sehajveersinghsaini/ecocar-onboarding-pcb/hardware/ecocar_onboarding/ecocar_onboarding.pdf

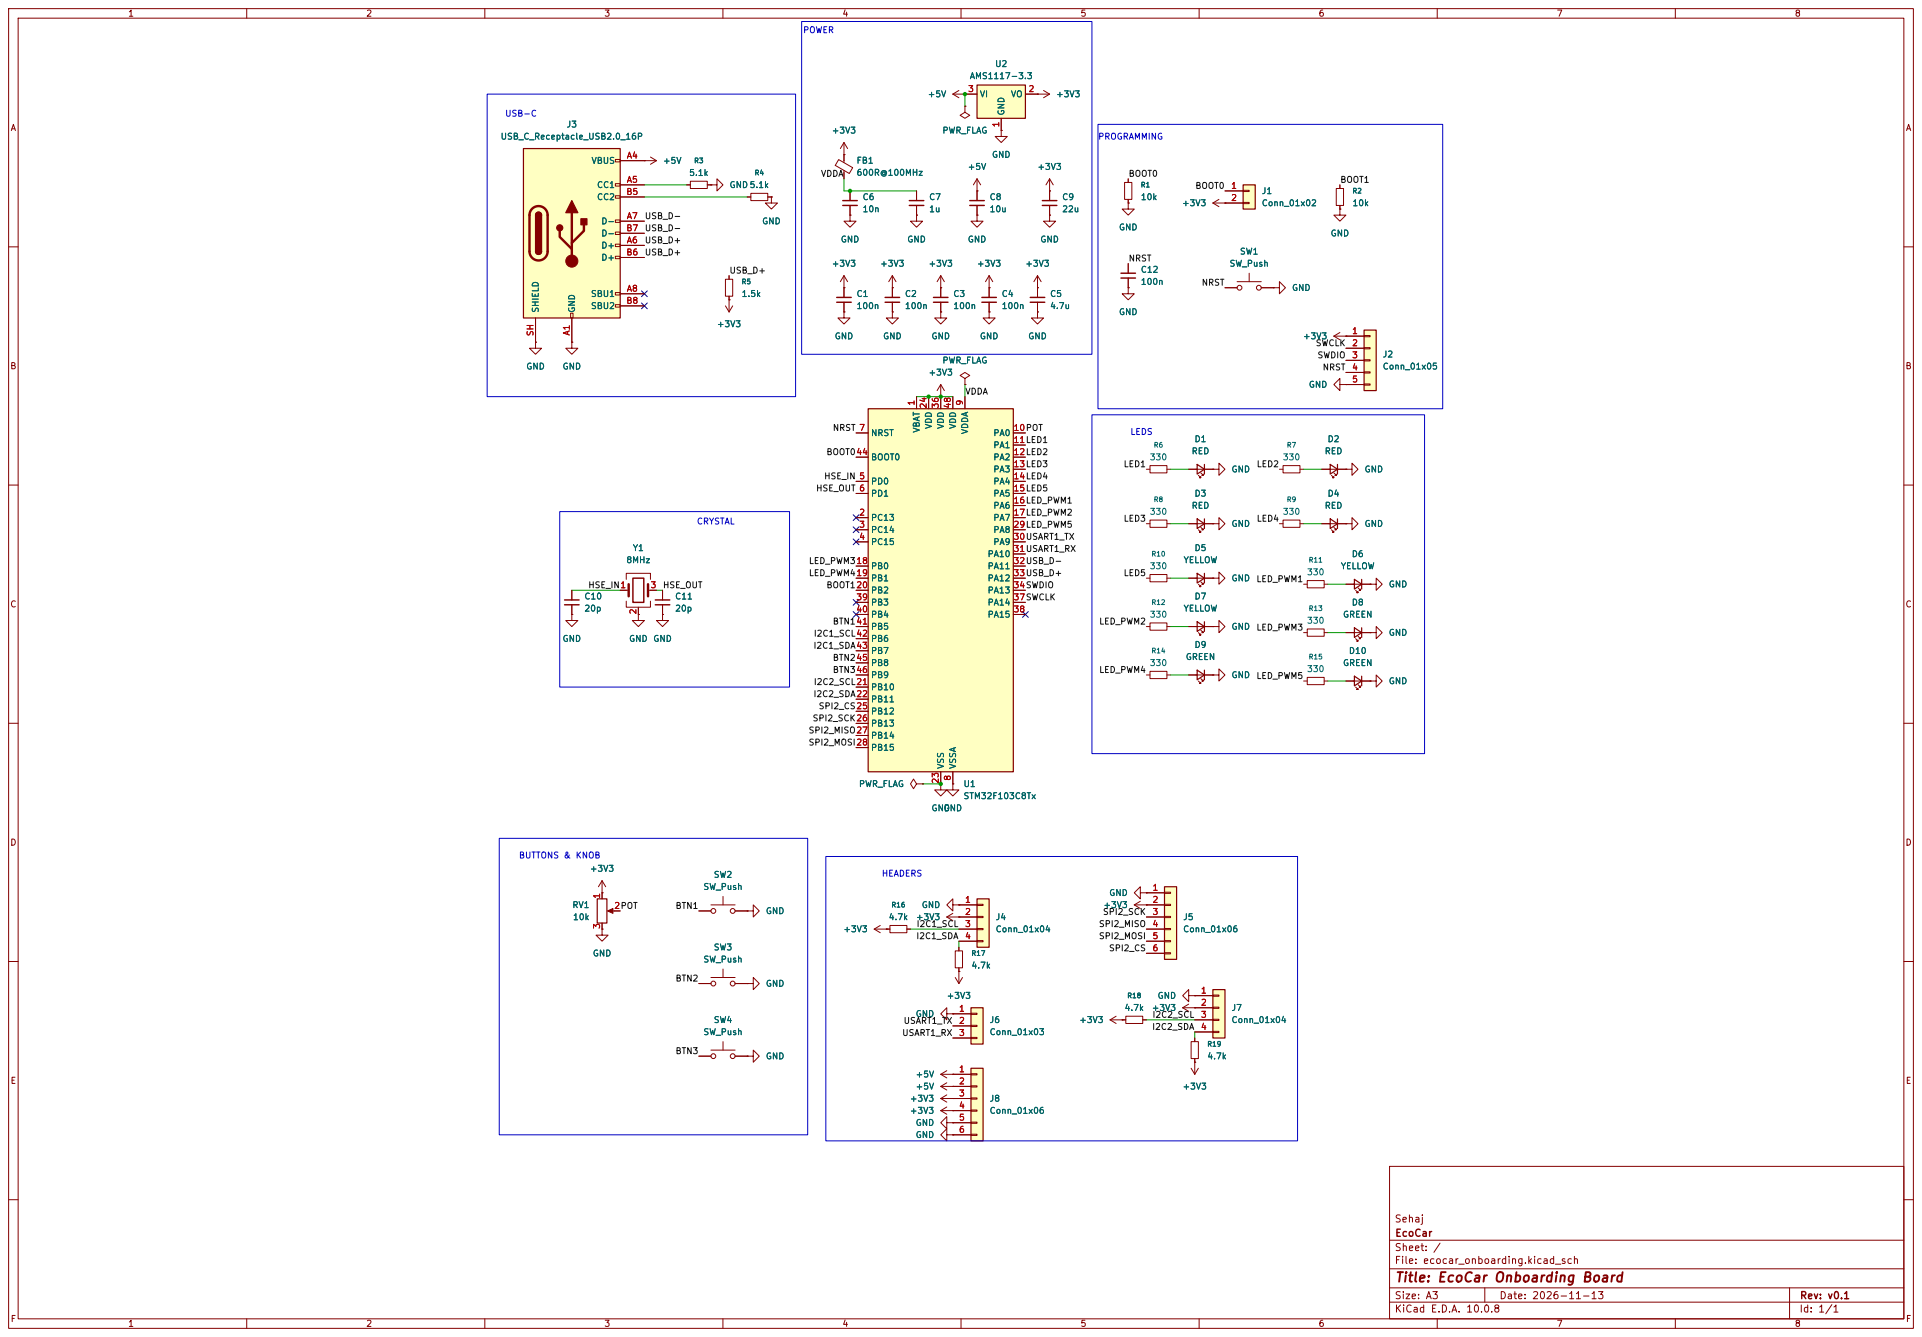
[picture p2: page 1]

Size: A3 | Rev: v0.1
KiCad E.D.A. 10.0.8 | Id: 1/1
