sehajveersinghsaini/ecocar-onboarding-pcb/hardware/ecocar_onboarding/ecocar_onboarding.kicad_pcb

## KiCad design hardware/ecocar_onboarding/ecocar_onboarding.kicad_pcb (2026-11-13)

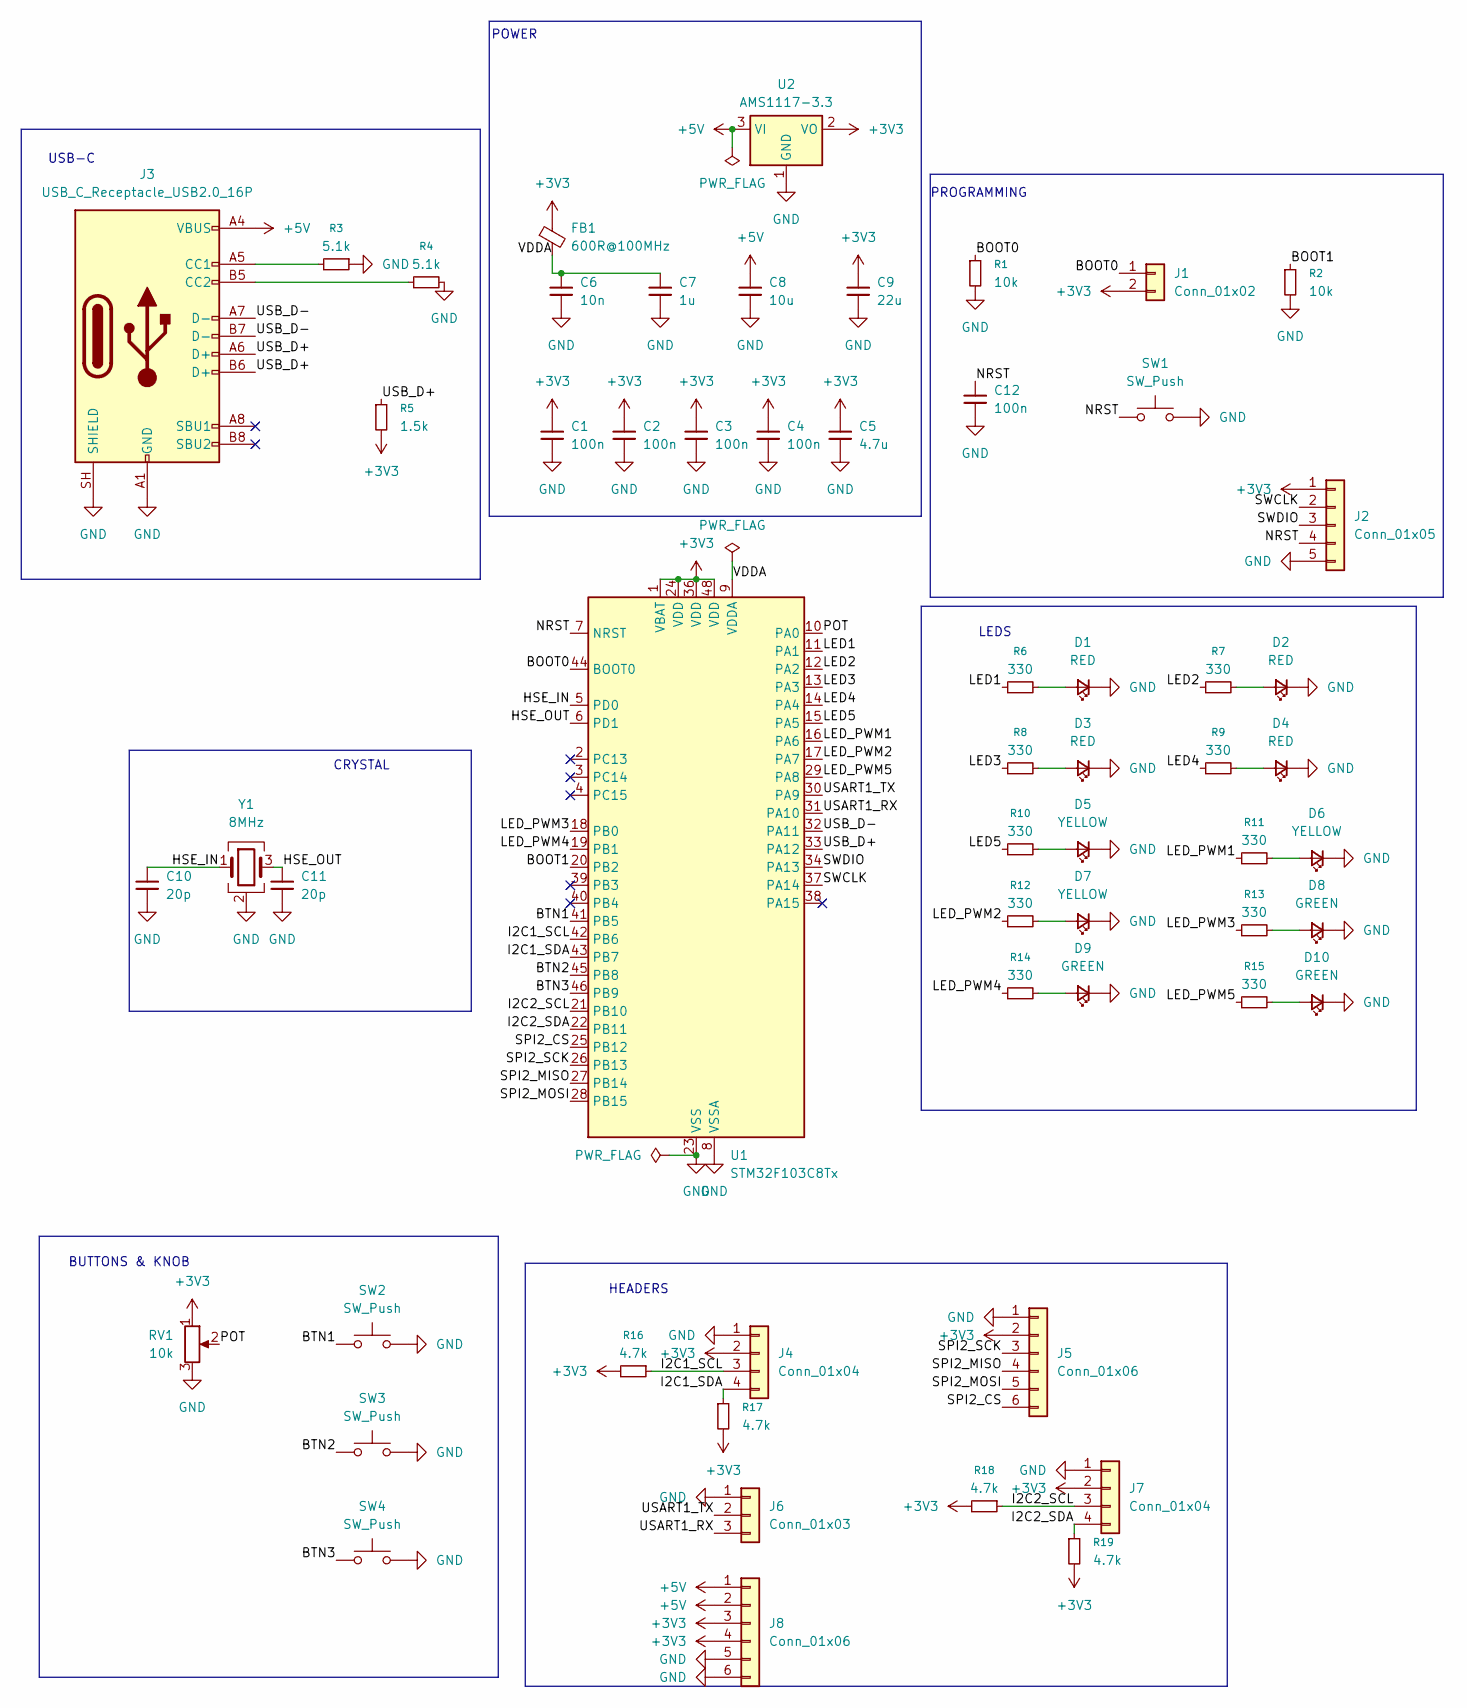
[picture p3: schematic ecocar_onboarding.kicad_sch, EcoCar Onboarding Board]

Parts:
C1, C2, C3, C4, C12: 100n; C_0603_1608Metric
C5: 4.7u; C_0805_2012Metric
C6: 10n; C_0603_1608Metric
C7: 1u; C_0603_1608Metric
C8: 10u; C_0805_2012Metric
C9: 22u; C_0805_2012Metric
C10, C11: 20p; C_0603_1608Metric
D1, D2, D3, D4: RED; LED_0603_1608Metric
D5, D6, D7: YELLOW; LED_0603_1608Metric
D8, D9, D10: GREEN; LED_0603_1608Metric
FB1: 600R@100MHz; L_0603_1608Metric
J1: Conn_01x02; PinHeader_1x02_P2.54mm_Vertical
J2: Conn_01x05; PinHeader_1x05_P2.54mm_Vertical
J3: USB_C_Receptacle_USB2.0_16P; USB_C_Receptacle_HRO_TYPE-C-31-M-12
J4, J7: Conn_01x04; PinHeader_1x04_P2.54mm_Vertical
J5, J8: Conn_01x06; PinHeader_1x06_P2.54mm_Vertical
J6: Conn_01x03; PinHeader_1x03_P2.54mm_Vertical
R1, R2: 10k; R_0603_1608Metric
R3, R4: 5.1k; R_0603_1608Metric
R5: 1.5k; R_0603_1608Metric
R6, R7, R8, R9, R10, R11, R12, R13, R14, R15: 330; R_0603_1608Metric
R16, R17, R18, R19: 4.7k; R_0603_1608Metric
RV1: 10k; Potentiometer_Bourns_3386P_Vertical
SW1, SW2, SW3, SW4: SW_Push; SW_PUSH_6mm
U1: STM32F103C8Tx; LQFP-48_7x7mm_P0.5mm
U2: AMS1117-3.3; SOT-223-3_TabPin2
Y1: 8MHz; Crystal_SMD_3225-4Pin_3.2x2.5mm

Connections:
+3V3: C1.1, C2.1, C3.1, C4.1, C5.1, C9.1, FB1.1, J1.2, J2.1, J4.2, J5.2, J7.2, J8.3, J8.4, R5.2, R16.2, R17.2, R18.2, R19.2, RV1.1, U1.1 (VBAT), U1.24 (VDD), U1.36 (VDD), U1.48 (VDD), U2.2 (VO)
+5V: C8.1, J3.A4 (VBUS), J3.A9 (VBUS), J3.B4 (VBUS), J3.B9 (VBUS), J8.1, J8.2, U2.3 (VI)
/BOOT0: J1.1, R1.1, U1.44 (BOOT0)
/BOOT1: R2.1, U1.20 (PB2)
/BTN1: SW2.1, U1.41 (PB5)
/BTN2: SW3.1, U1.45 (PB8)
/BTN3: SW4.1, U1.46 (PB9)
/HSE_IN: C10.1, U1.5 (PD0), Y1.1
/HSE_OUT: C11.1, U1.6 (PD1), Y1.3
/I2C1_SCL: J4.3, R16.1, U1.42 (PB6)
/I2C1_SDA: J4.4, R17.1, U1.43 (PB7)
/I2C2_SCL: J7.3, R18.1, U1.21 (PB10)
/I2C2_SDA: J7.4, R19.1, U1.22 (PB11)
/LED1: R6.1, U1.11 (PA1)
/LED2: R7.1, U1.12 (PA2)
/LED3: R8.1, U1.13 (PA3)
/LED4: R9.1, U1.14 (PA4)
/LED5: R10.1, U1.15 (PA5)
/LED_PWM1: R11.1, U1.16 (PA6)
/LED_PWM2: R12.1, U1.17 (PA7)
/LED_PWM3: R13.1, U1.18 (PB0)
/LED_PWM4: R14.1, U1.19 (PB1)
/LED_PWM5: R15.1, U1.29 (PA8)
/NRST: C12.1, J2.4, SW1.1, U1.7 (NRST)
/POT: RV1.2, U1.10 (PA0)
/SPI2_CS: J5.6, U1.25 (PB12)
/SPI2_MISO: J5.4, U1.27 (PB14)
/SPI2_MOSI: J5.5, U1.28 (PB15)
/SPI2_SCK: J5.3, U1.26 (PB13)
/SWCLK: J2.2, U1.37 (PA14)
/SWDIO: J2.3, U1.34 (PA13)
/USART1_RX: J6.3, U1.31 (PA10)
/USART1_TX: J6.2, U1.30 (PA9)
/USB_D+: J3.A6 (D+), J3.B6 (D+), R5.1, U1.33 (PA12)
/USB_D-: J3.A7 (D-), J3.B7 (D-), U1.32 (PA11)
/VDDA: C6.1, C7.1, FB1.2, U1.9 (VDDA)
GND: C1.2, C2.2, C3.2, C4.2, C5.2, C6.2, C7.2, C8.2, C9.2, C10.2, C11.2, C12.2, D1.1 (K), D2.1 (K), D3.1 (K), D4.1 (K), D5.1 (K), D6.1 (K), D7.1 (K), D8.1 (K), D9.1 (K), D10.1 (K), J2.5, J3.A1 (GND), J3.A12 (GND), J3.B1 (GND), J3.B12 (GND), J3.SH (SHIELD), J4.1, J5.1, J6.1, J7.1, J8.5, J8.6, R1.2, R2.2, R3.1, R4.2, RV1.3, SW1.2, SW2.2, SW3.2, SW4.2, U1.8 (VSSA), U1.23 (VSS), U1.35 (VSS), U1.47 (VSS), U2.1 (GND), Y1.2 (G), Y1.4 (G)
unnamed: D1.2 (A), R6.2
unnamed: D2.2 (A), R7.2
unnamed: D3.2 (A), R8.2
unnamed: D4.2 (A), R9.2
unnamed: D5.2 (A), R10.2
unnamed: D6.2 (A), R11.2
unnamed: D7.2 (A), R12.2
unnamed: D8.2 (A), R13.2
unnamed: D9.2 (A), R14.2
unnamed: D10.2 (A), R15.2
unnamed: J3.A5 (CC1), R3.2
unnamed: J3.B5 (CC2), R4.1

Notes on the sheet:
PROGRAMMING
POWER
CRYSTAL
USB-C
HEADERS
BUTTONS & KNOB
LEDS

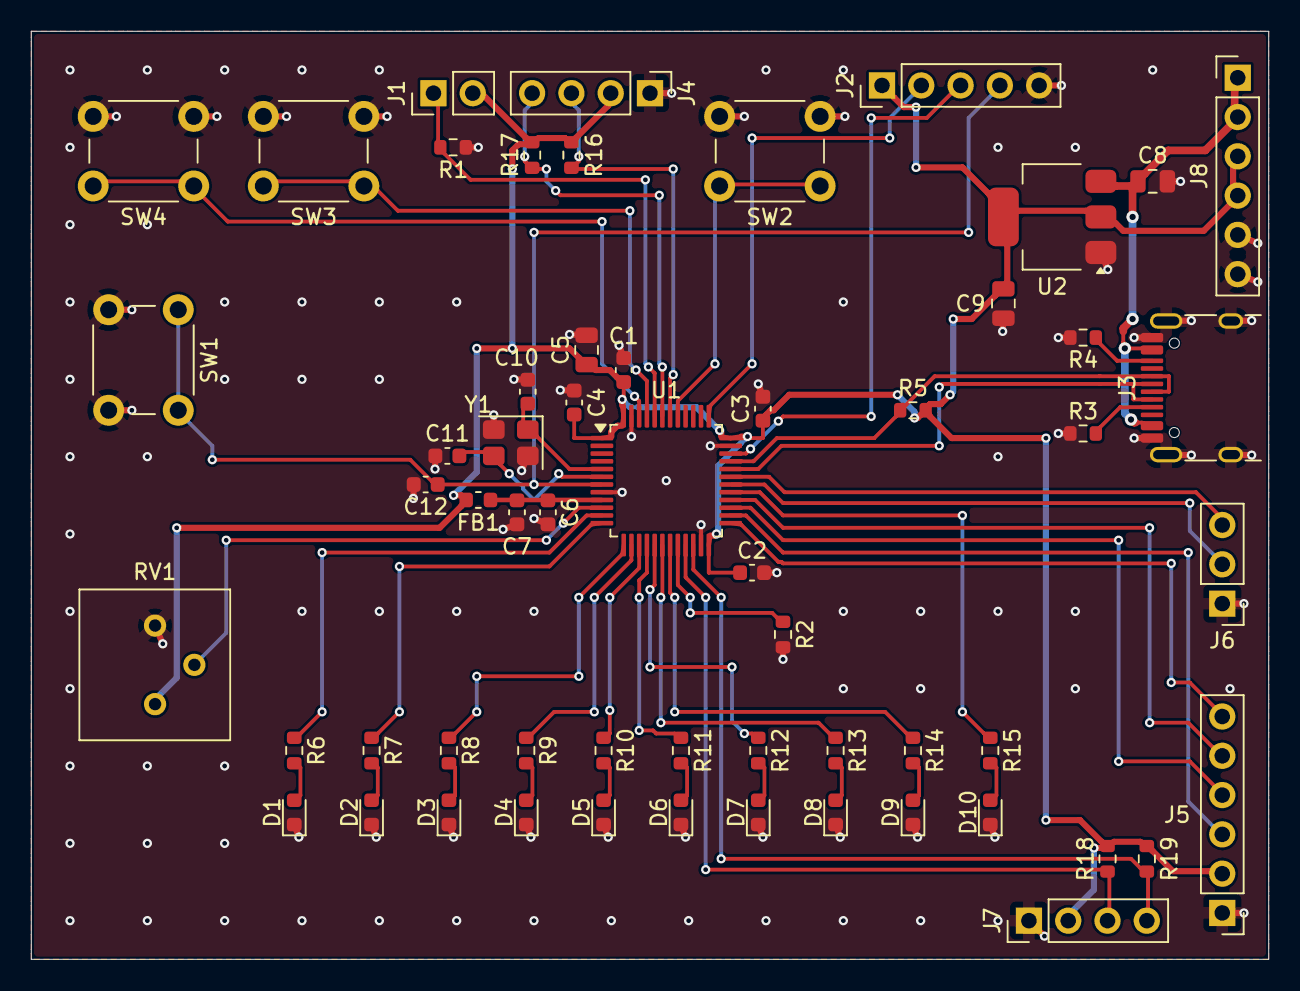
[picture p4: board ecocar_onboarding.kicad_pcb from above]

Board: 2 copper layers, 80.0 x 60.0 mm, 58 parts (0 on the bottom side), 49 nets.
