sehajveersinghsaini/ecocar-onboarding-pcb/firmware/ecocar_onboarding.ioc

Mcu.UserName=STM32F103C8Tx
PA0-WKUP.GPIO_Label=POT
PA0-WKUP.Signal=ADCx_IN0
PA1.GPIO_Label=LED1
PA1.Signal=GPIO_Output
PA10.Signal=USART1_RX
PA11.Signal=USB_DM
PA12.Signal=USB_DP
PA13.Signal=SYS_JTMS-SWDIO
PA14.Signal=SYS_JTCK-SWCLK
PA2.GPIO_Label=LED2
PA2.Signal=GPIO_Output
PA3.GPIO_Label=LED3
PA3.Signal=GPIO_Output
PA4.GPIO_Label=LED4
PA4.Signal=GPIO_Output
PA5.GPIO_Label=LED5
PA5.Signal=GPIO_Output
PA6.GPIO_Label=LED_PWM1
PA6.Signal=S_TIM3_CH1
PA7.GPIO_Label=LED_PWM2
PA7.Signal=S_TIM3_CH2
PA8.GPIO_Label=LED_PWM5
PA8.Signal=S_TIM1_CH1
PA9.Signal=USART1_TX
PB0.GPIO_Label=LED_PWM3
PB0.Signal=S_TIM3_CH3
PB1.GPIO_Label=LED_PWM4
PB1.Signal=S_TIM3_CH4
PB10.Signal=I2C2_SCL
PB11.Signal=I2C2_SDA
PB12.GPIO_Label=SPI2_CS
PB12.Signal=GPIO_Output
PB13.Signal=SPI2_SCK
PB14.Signal=SPI2_MISO
PB15.Signal=SPI2_MOSI
PB5.GPIO_Label=BTN1
PB5.Signal=GPIO_Input
PB6.Signal=I2C1_SCL
PB7.Signal=I2C1_SDA
PB8.GPIO_Label=BTN2
PB8.Signal=GPIO_Input
PB9.GPIO_Label=BTN3
PB9.Signal=GPIO_Input
PD0-OSC_IN.Signal=RCC_OSC_IN
PD1-OSC_OUT.Signal=RCC_OSC_OUT
