sehajveersinghsaini/ecocar-onboarding-pcb/(commit log)

2026-10-31 Add knob and LED pins
2026-10-31 Add SPI2 pins and fix LED_PWM5 label
    [ecocar_onboarding.ioc]
2026-11-01 Create KiCad project and place STM32
    [ecocar_onboarding.kicad_pcb, ecocar_onboarding.kicad_sch]
2026-11-11 Create KiCad project, place STM32, lay out schematic blocks
    [ecocar_onboarding.kicad_sch]
2026-11-13 Schematic complete, ERC clean
    [ecocar_onboarding.kicad_sch]
2026-11-13 Schematic cleanup, add schematic PDF, stop tracking KiCad .history
    [ecocar_onboarding.kicad_sch]
2026-11-13 PCB: rules, outline, import parts
    [ecocar_onboarding.kicad_pcb]
2026-11-13 PCB layout: placement, routing, GND pours both layers, DRC clean
    [ecocar_onboarding.kicad_pcb]
2026-11-13 Final design: LED colours, 6-pin power header, horizontal/vertical routing, README
    [ecocar_onboarding.kicad_pcb, ecocar_onboarding.kicad_sch]
2026-11-13 CubeMX: buttons as inputs with pull-ups, 72 MHz from HSE crystal, USB 48 MHz, STM32CubeIDE toolchain
